clockdiv/KafkaShoes/img/sender.jpg

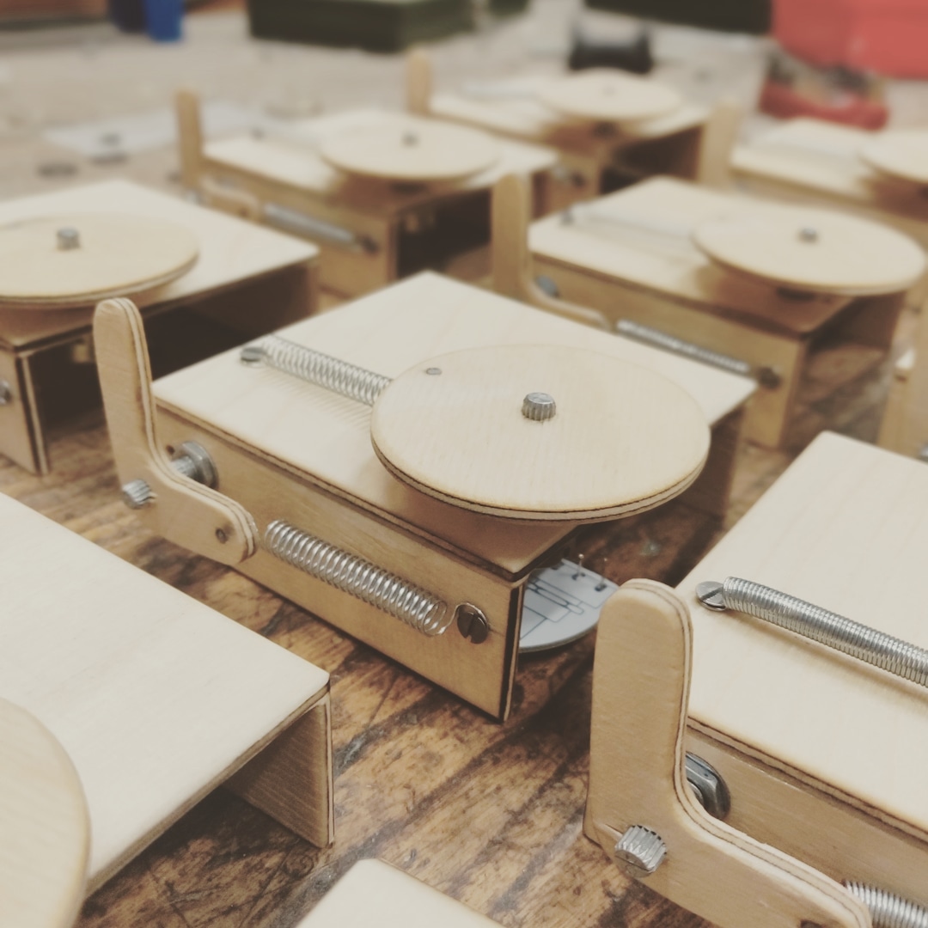
img/sender.jpg
