clockdiv/KafkaShoes/img/shoes_02.jpg

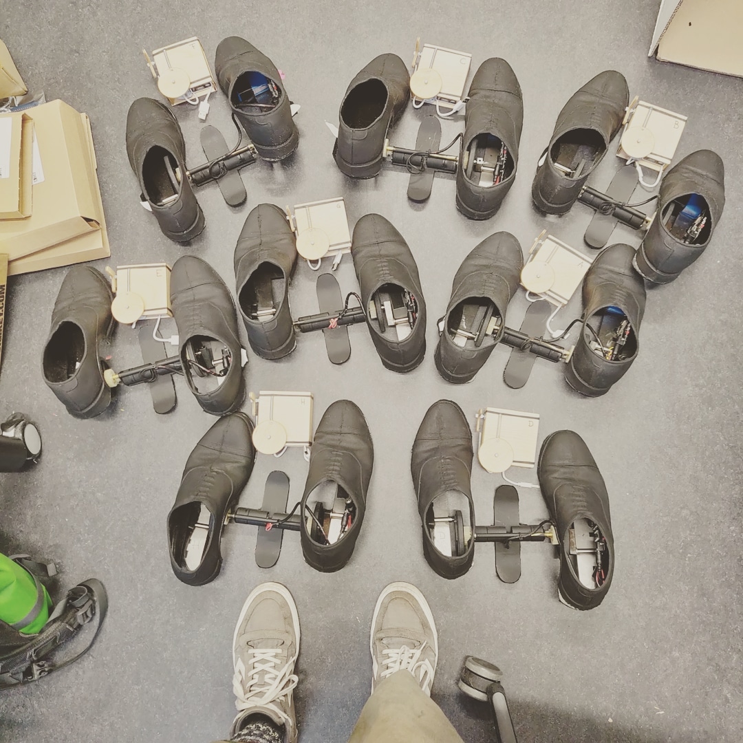
img/shoes_02.jpg
