clockdiv/KafkaShoes/img/shoes_pcb.jpg

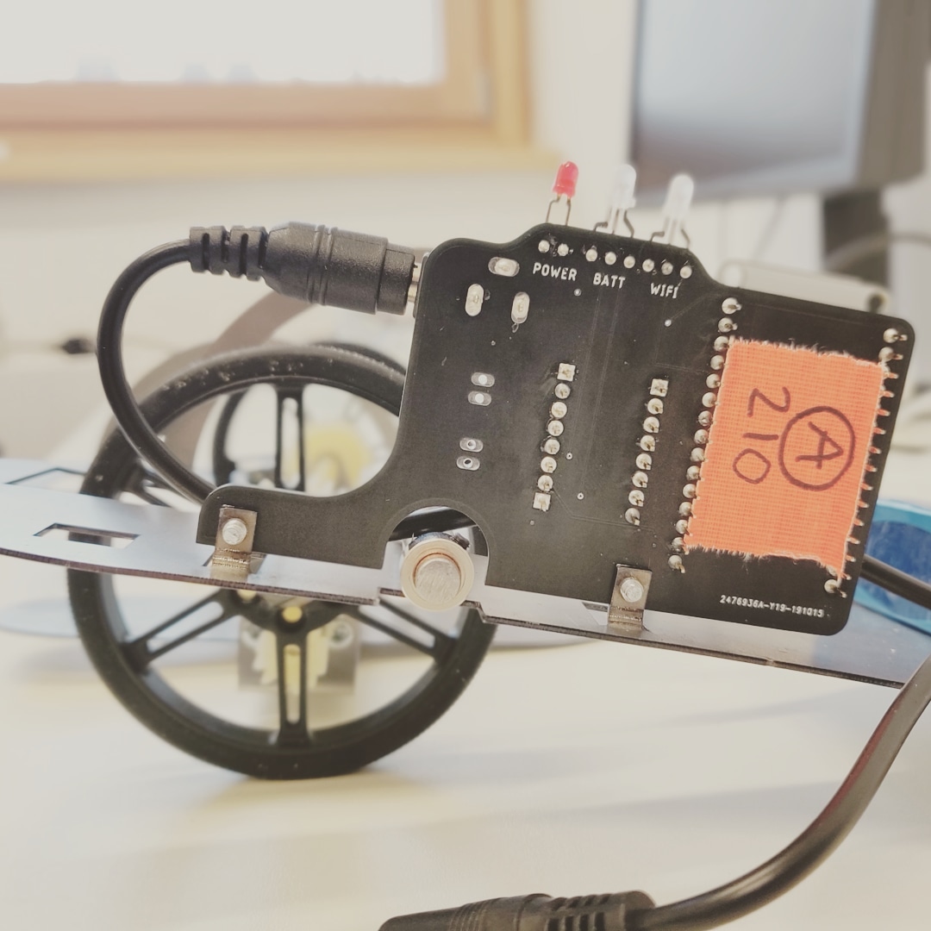
img/shoes_pcb.jpg
