clockdiv/KafkaShoes/HARDWARE/LASER PARTS/Schuhsohle_v02.dxf

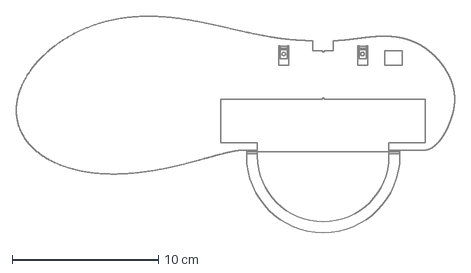
[picture p5: CAD file, 2022-01-22]
HARDWARE/LASER PARTS/Schuhsohle_v02.dxf
30.0 x 14.8 cm
