clockdiv/KafkaShoes/HARDWARE/LASER PARTS/Grundplatte_v02.dxf

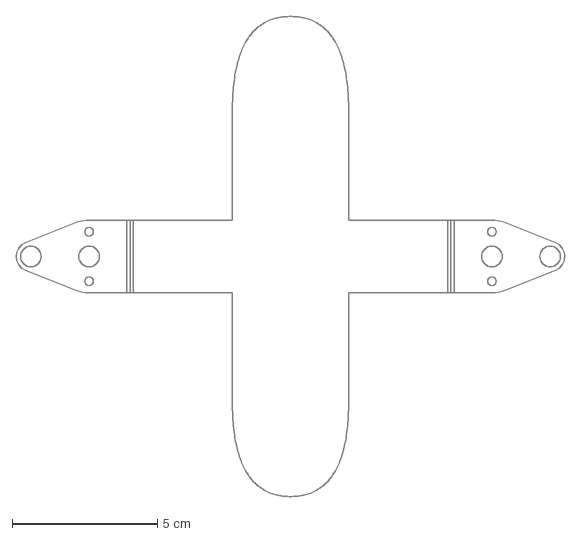
[picture p6: CAD file, 2022-01-22]
HARDWARE/LASER PARTS/Grundplatte_v02.dxf
18.9 x 16.5 cm
