clockdiv/KafkaShoes/HARDWARE/LASER PARTS/Schuhsohle_v01.dxf

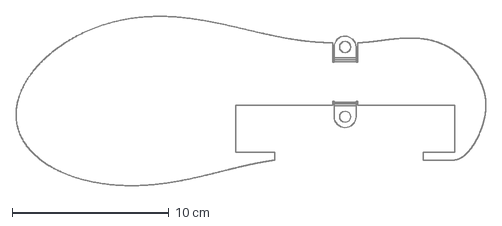
[picture p7: CAD file, 2022-01-22, an earlier design]
HARDWARE/LASER PARTS/Schuhsohle_v01.dxf
30.0 x 10.8 cm
