clockdiv/KafkaShoes/img/shoes_assembly.jpg

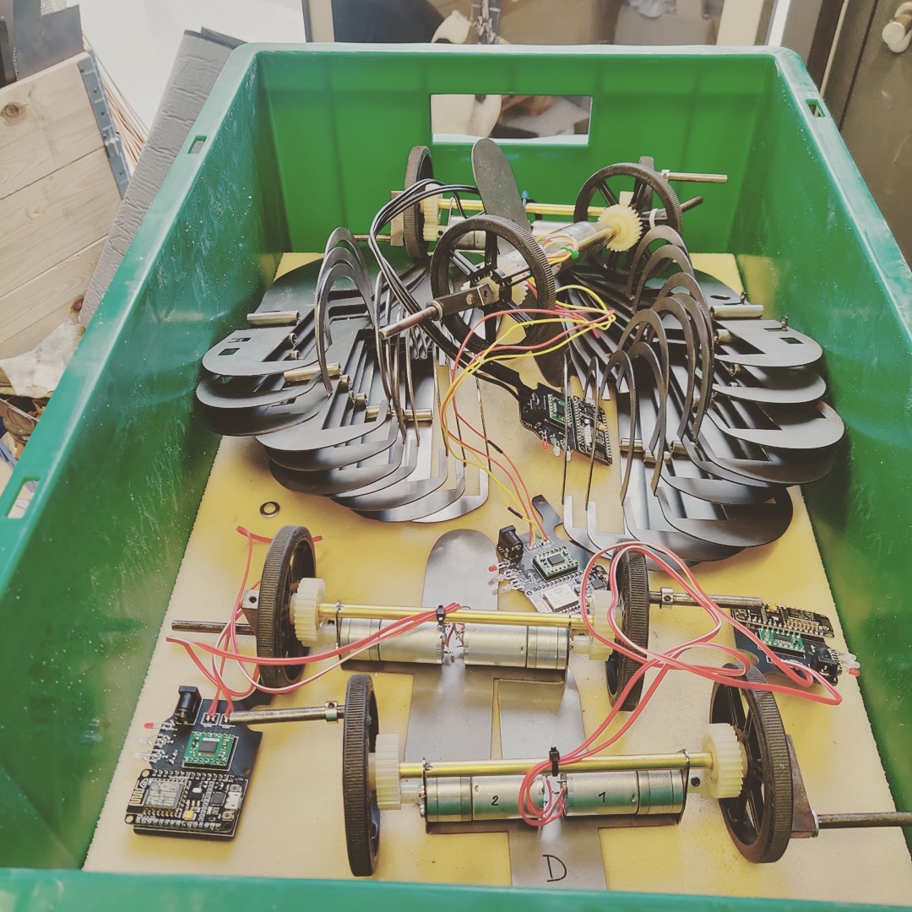
img/shoes_assembly.jpg
