clockdiv/KafkaShoes/HARDWARE/PCB EAGLE/Kafka Schuh V1.3/kafka.pdf

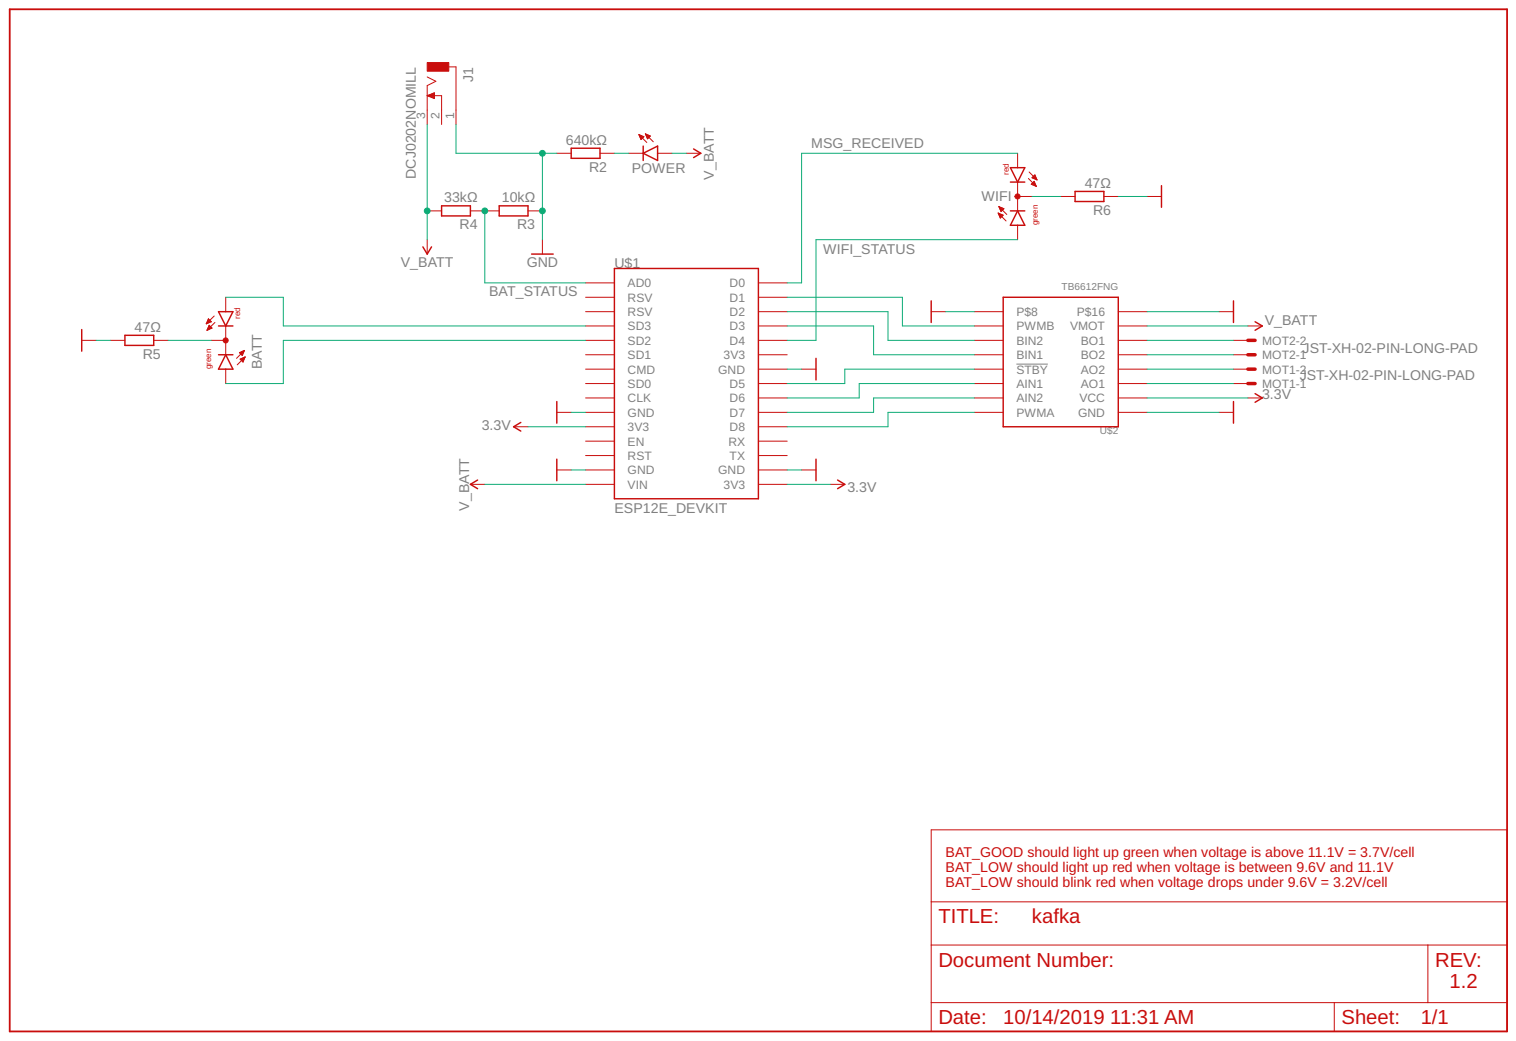
[picture p9: page 1]

JST-XH-02-PIN-LONG-PAD

BAT_GOOD should light up green when voltage is above 11.1V = 3.7V/cell
BAT_LOW should light up red when voltage is between 9.6V and 11.1V
BAT_LOW should blink red when voltage drops under 9.6V = 3.2V/cell
TITLE:

Document Number: | REV: 1.2

Date: 10/14/2019 11:31 AM | Sheet: 1/1

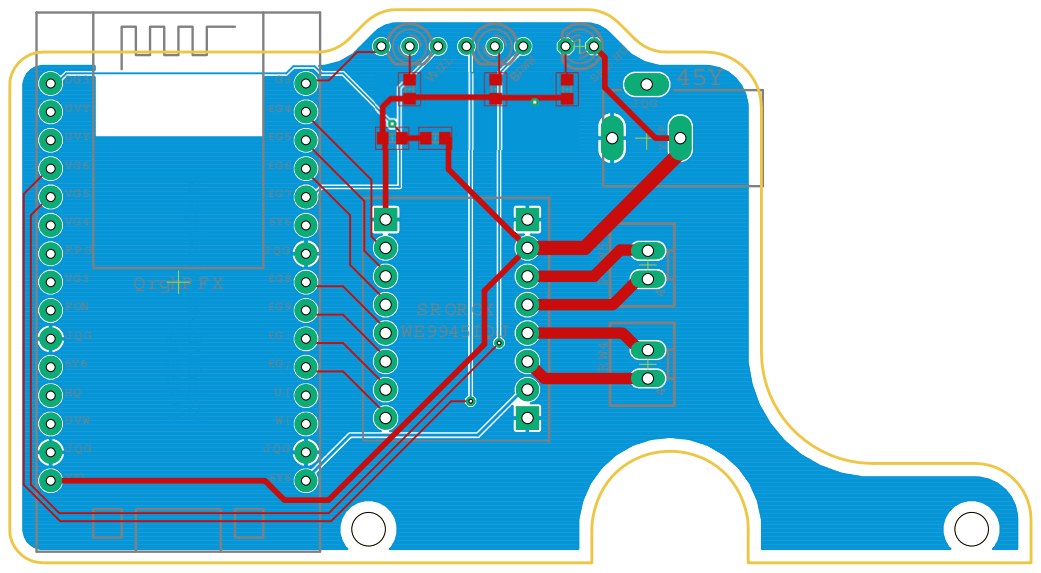
[picture p10: page 2]
VCC; GND; RSV; RST; VIN; IFI; ATT

"Kafka Schuhe" Version 1.3

CMD GND

SD0 N odeM C U | ~D 5
C LK ~D 6 | PO LO LU
GND ~D 7 | TB6612FN G

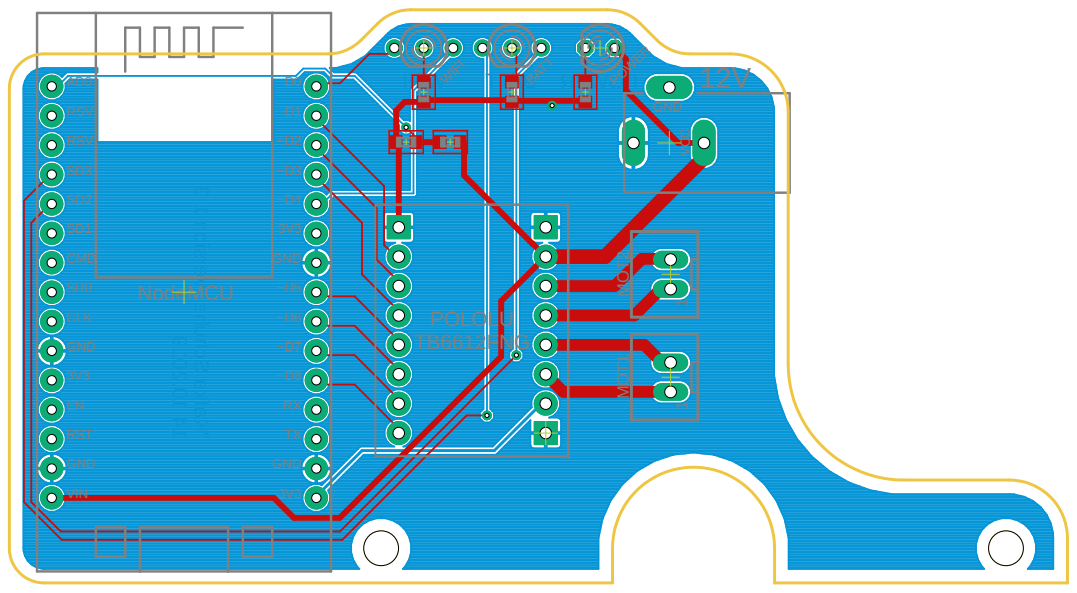
[picture p11: page 3]

"Kafka Schuhe" Version 1.3 14.10.2019 I FI W TTAB RE WOP POLOLU TB6612FNG VCC GND AD0 RSV RSV SD3 SD2 SD1 CMD SD0 CLK GND 3V3 ENRST GND VIN 3V3 GNDTXRX ~D8 ~D7 ~D6 ~D5 GND 3V3 ~D4 ~D3 ~D2 ~D1 D0 1 1 12V NodeMCU WIFI BAT POWER MOT2 MOT1
