clockdiv/KafkaShoes/HARDWARE/LASER PARTS/Kafka_Schuhe_v02.pdf

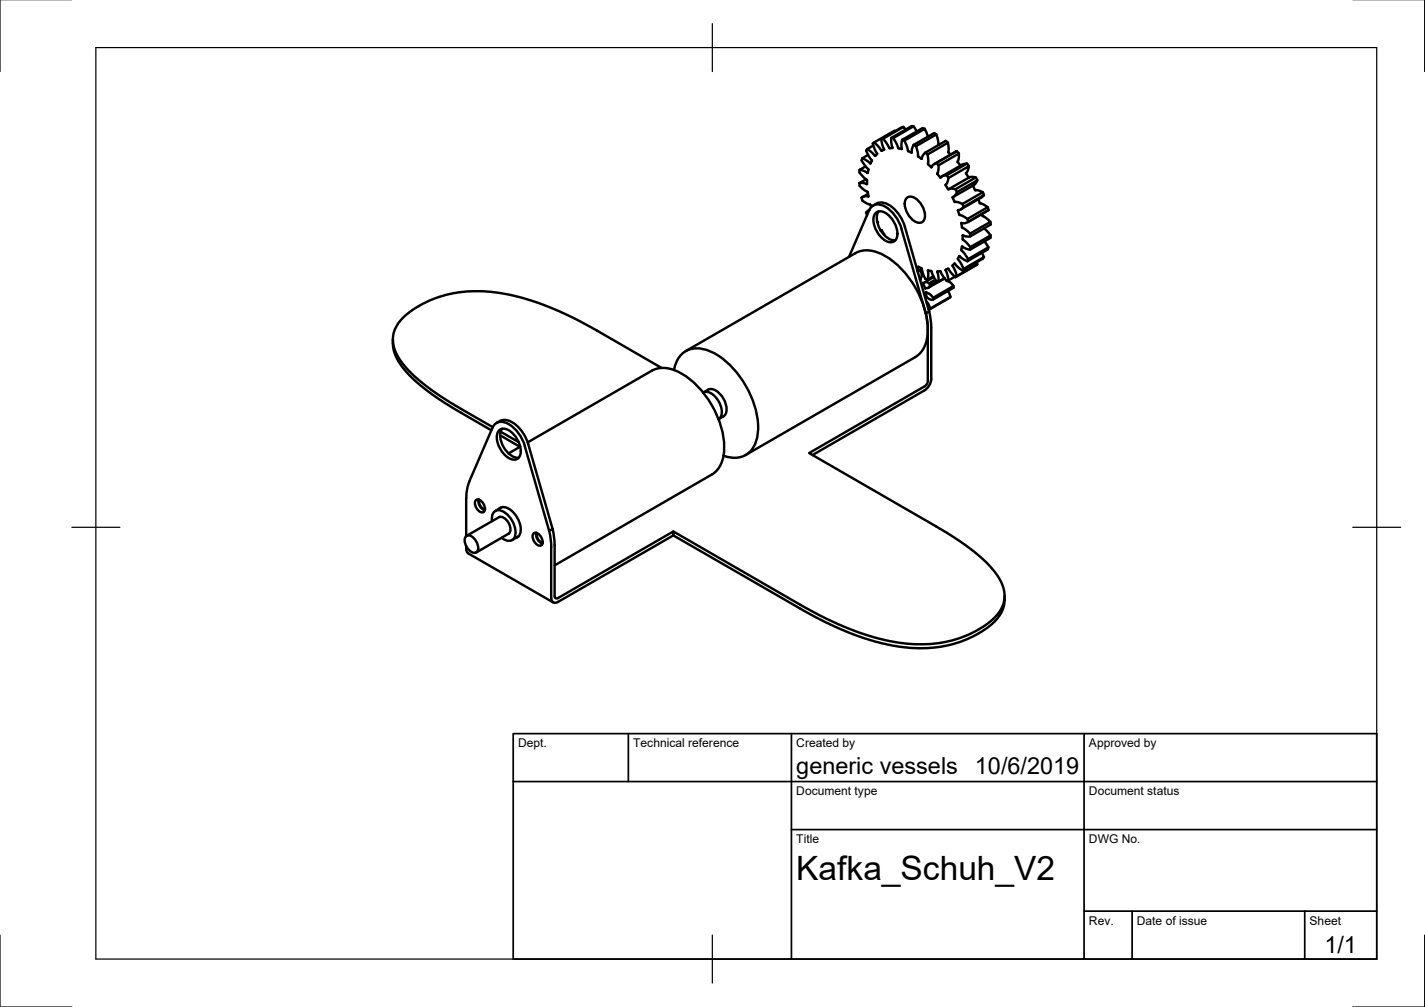
[picture p12: page 1]

Dept. | Technical reference | Created by generic vessels 10/6/2019 | Approved by

Document type | Document status

Title Kafka_Schuh_V2 | DWG No.

Rev. | Date of issue | Sheet

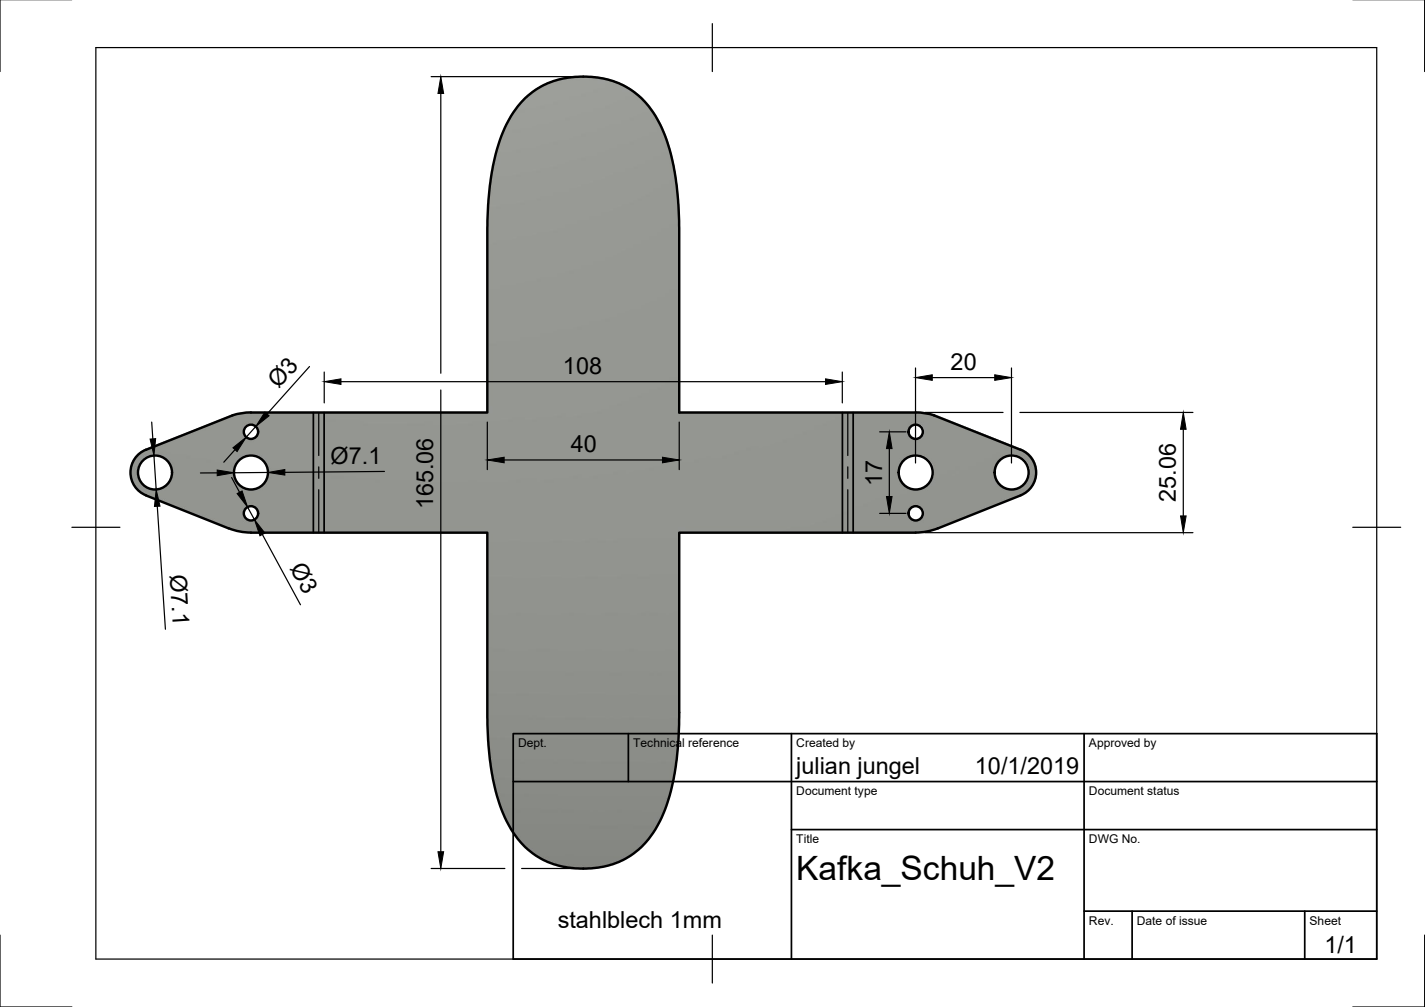
[picture p13: page 2]

Dept. | Technical reference | Created by julian jungel 10/1/2019 | Approved by

stahlblech 1mm | | Document type | Document status

Title Kafka_Schuh_V2 | DWG No.

Rev. | Date of issue | Sheet

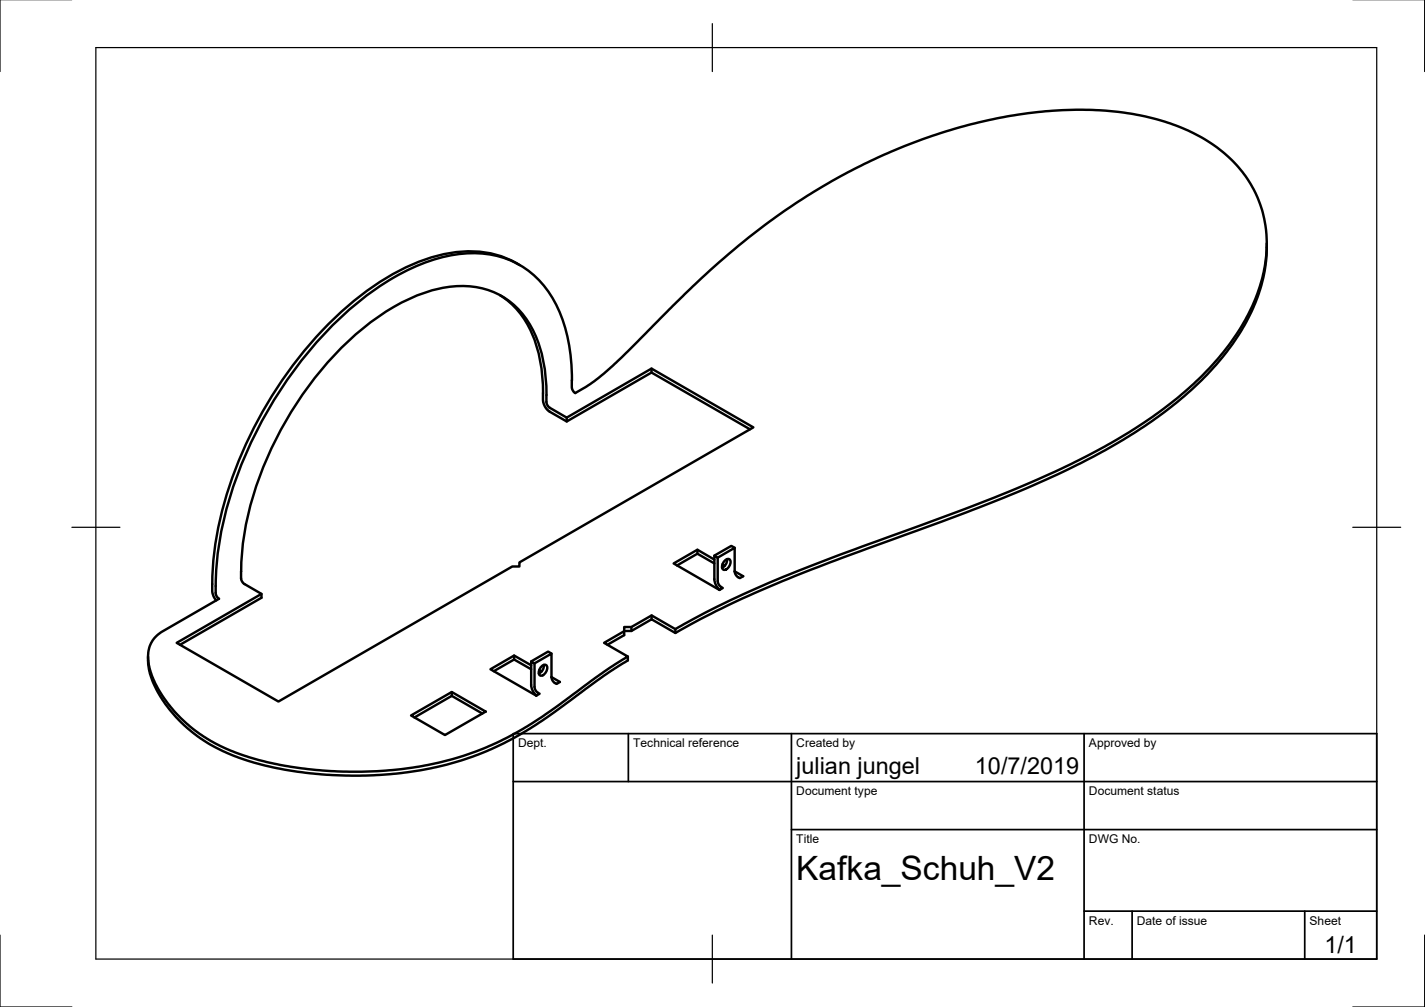
[picture p14: page 3]

Dept. | Technical reference | Created by julian jungel 10/7/2019 | Approved by

Document type | Document status

Title Kafka_Schuh_V2 | DWG No.

Rev. | Date of issue | Sheet

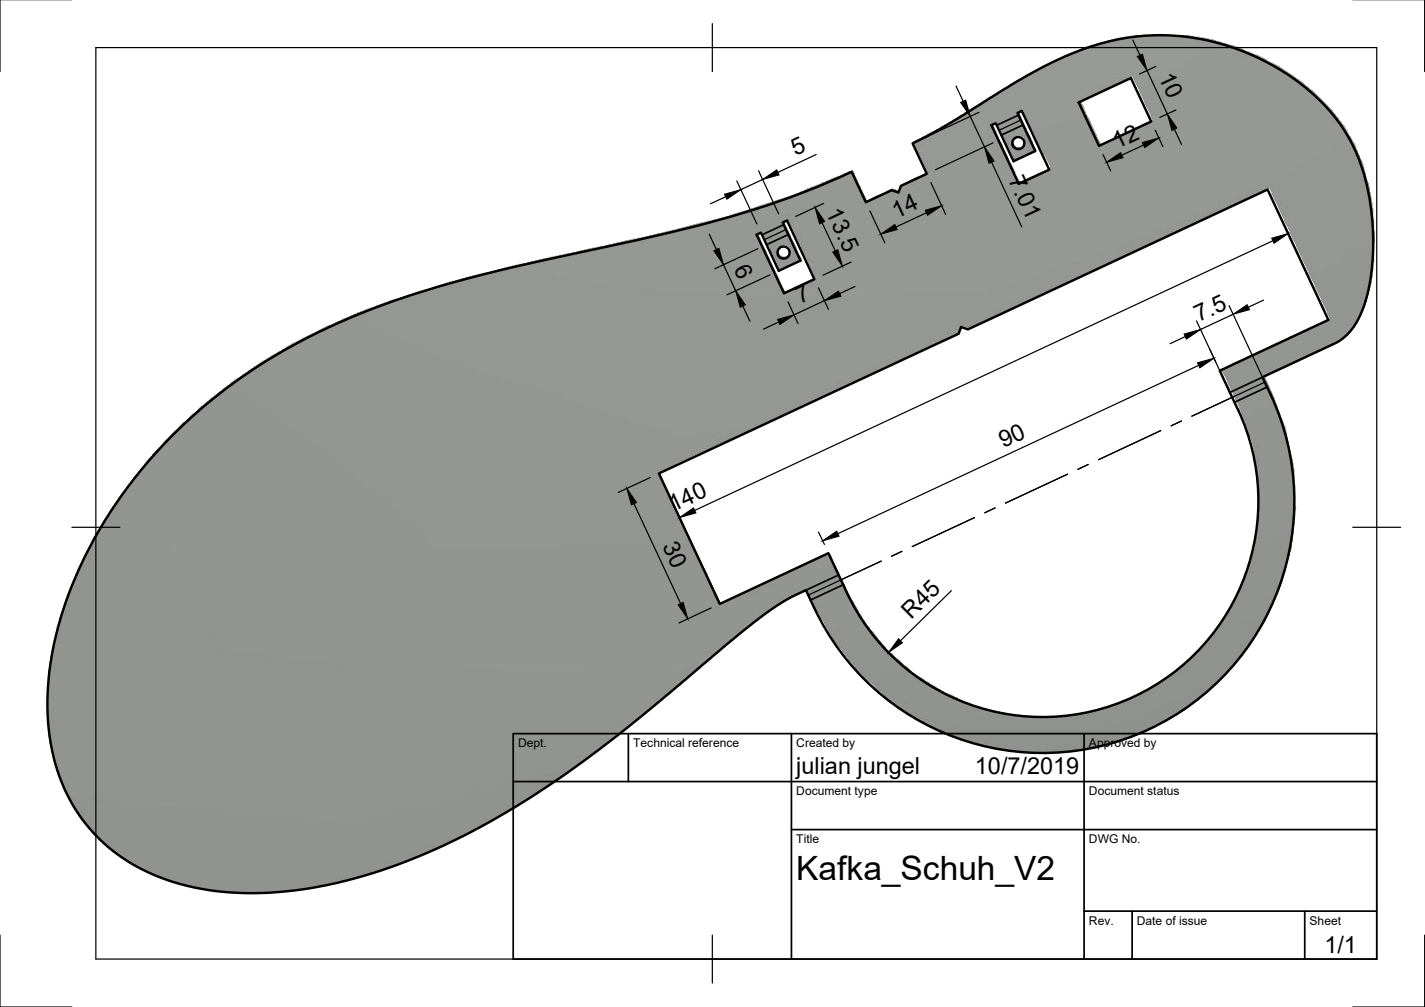
[picture p15: page 4]

Dept. | Technical reference | Created by julian jungel 10/7/2019 | Approved by

Document type | Document status

Title Kafka_Schuh_V2 | DWG No.

Rev. | Date of issue | Sheet
