clockdiv/KafkaShoes/HARDWARE/PCB EAGLE/Kafka Fernsteuerung V1.0/fernsteuerung.brd

## EAGLE design HARDWARE/PCB EAGLE/Kafka Fernsteuerung V1.0/fernsteuerung.brd (2022-01-22)

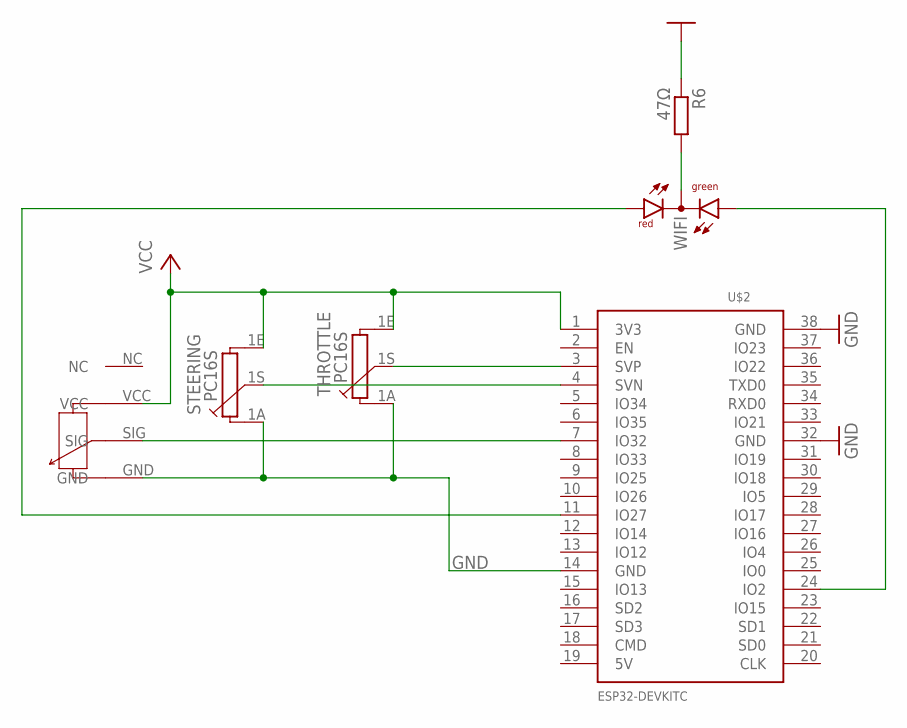
[picture p16: schematic fernsteuerung.sch]

Parts:
R6: 47Ω; R0603
STEERING: PC16S
THROTTLE: PC16S
TRIM: ALPS_RK11K
U$2: ESP32DEVKITC; ESP32-DEVKITC
WIFI: DUOLED-RG-C3MM; DUOLED-A-3MM

Connections:
GND: R6.1, STEERING.1A, THROTTLE.1A, TRIM.GND, U$2.14 (GND), U$2.32 (GND), U$2.38 (GND)
unnamed: U$2.11 (IO27), WIFI.3 (AR)
unnamed: TRIM.SIG, U$2.7 (IO32)
unnamed: STEERING.1S, U$2.4 (SVN)
unnamed: THROTTLE.1S, U$2.3 (SVP)
unnamed: R6.2, WIFI.2 (C)
VCC: STEERING.1E, THROTTLE.1E, TRIM.VCC, U$2.1 (3V3)
WIFI_STATUS: U$2.24 (IO2), WIFI.1 (AG)

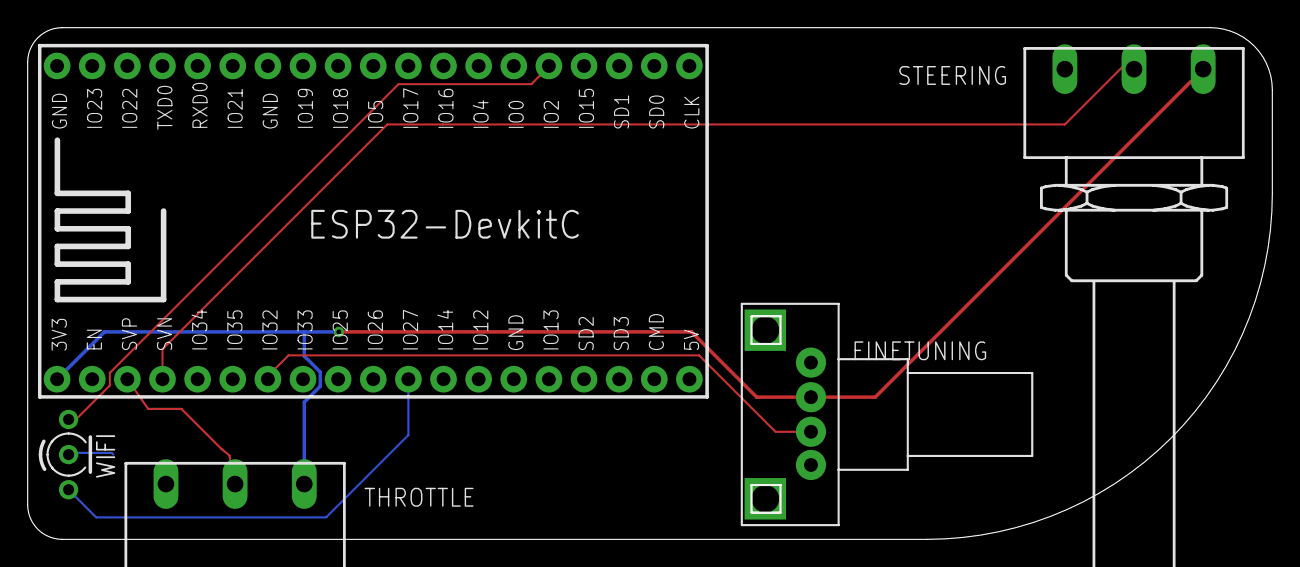
[picture p17: board fernsteuerung.brd from above]

Board: 2 copper layers, 90.0 x 37.0 mm, 6 parts (1 on the bottom side), 8 nets.
