clockdiv/KafkaShoes/HARDWARE/PCB EAGLE/Kafka Schuh V1.3/kafka.brd

## EAGLE design HARDWARE/PCB EAGLE/Kafka Schuh V1.3/kafka.brd (2022-01-22)

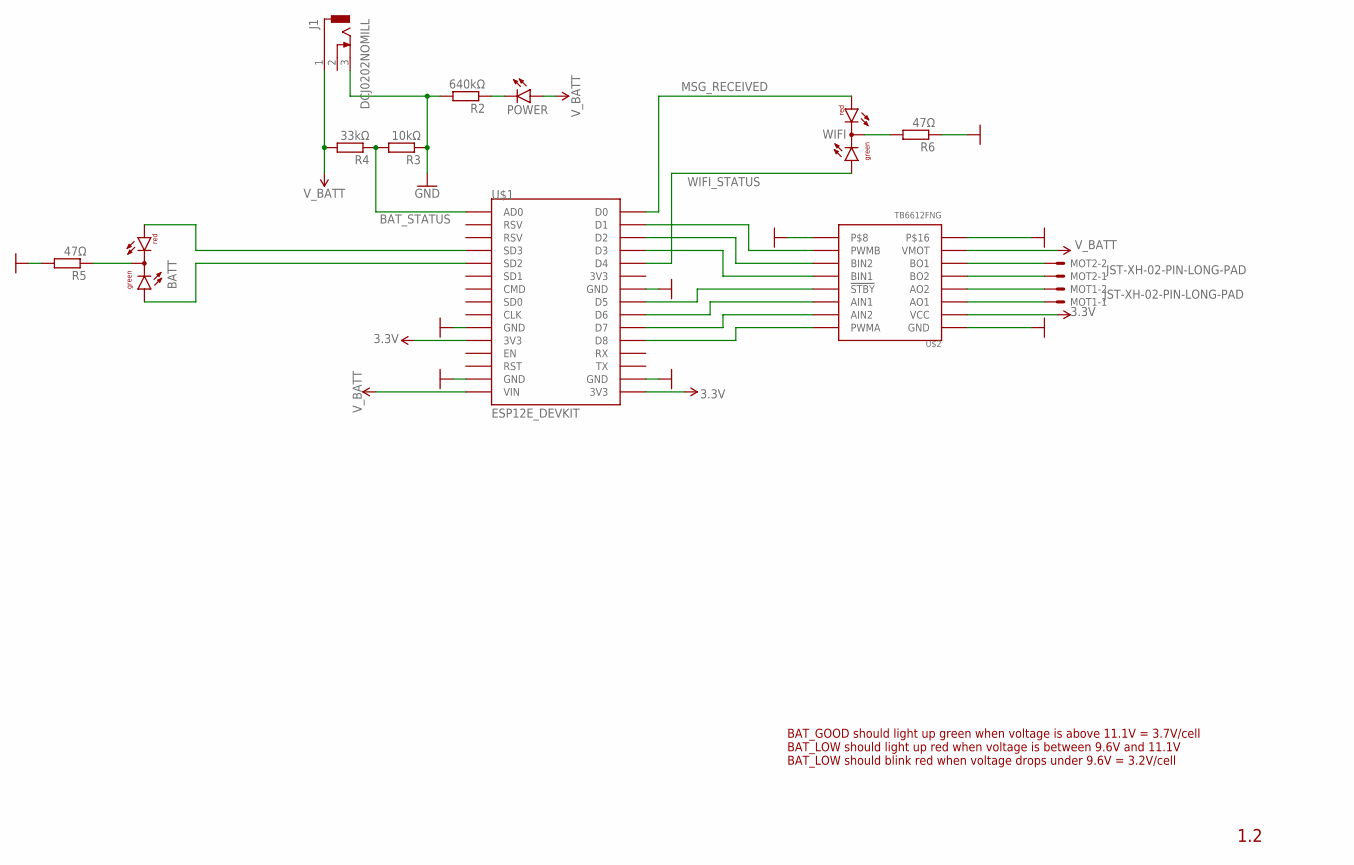
[picture p18: schematic kafka.sch]

Parts:
BATT: DUOLED-RG-C3MM; DUOLED-A-3MM
J1: DCJ0202NOMILL; DCJ0202_NOMILL
MOT1, MOT2: JST-XH-02-PIN-LONG-PAD; JST-XH-02-PACKAGE-LONG-PAD
POWER: LED3MM
R2: 640kΩ; R0603
R3: 10kΩ; R0603
R4: 33kΩ; R0603
R5, R6: 47Ω; R0603
U$1: ESP12E_DEVKIT
U$2: TB6612FNG
WIFI: DUOLED-RG-C3MM; DUOLED-A-3MM

Connections:
3.3V: U$1.3V3@2 (3V3), U$2.VCC
AIN1: U$1.D6, U$2.AIN1
AIN2: U$1.D7, U$2.AIN2
BAT_STATUS: R3.2, R4.1, U$1.AD0
BIN1: U$1.D3, U$2.BIN1
BIN2: U$1.D2, U$2.BIN2
GND: J1.3, R2.2, R3.1, R5.2, R6.1, U$1.GND@0 (GND), U$1.GND@1 (GND), U$1.GND@2 (GND), U$1.GND@3 (GND), U$2.GND, U$2.TB6612FNG1, U$2.TB6612FNG2
MSG_RECEIVED: U$1.D0, WIFI.3 (AR)
unnamed: MOT2.2, U$2.BO1
unnamed: MOT2.1, U$2.BO2
unnamed: MOT1.2, U$2.AO2
unnamed: MOT1.1, U$2.AO1
unnamed: R6.2, WIFI.2 (C)
unnamed: POWER.K (C), R2.1
unnamed: BATT.1 (AG), U$1.SD2
unnamed: BATT.3 (AR), U$1.SD3
unnamed: BATT.2 (C), R5.1
PWMA: U$1.D8, U$2.PWMA
PWMB: U$1.D1, U$2.PWMB
STBY: U$1.D5, U$2.!STBY
V_BATT: J1.1, POWER.A, R4.2, U$1.VIN, U$2.VMOT
WIFI_STATUS: U$1.D4, WIFI.1 (AG)

Notes on the sheet:
1.2
BAT_GOOD should light up green when voltage is above 11.1V = 3.7V/cell BAT_LOW should light up red when voltage is between 9.6V and 11.1V BAT_LOW should blink red when voltage drops under 9.6V = 3.2V/cell

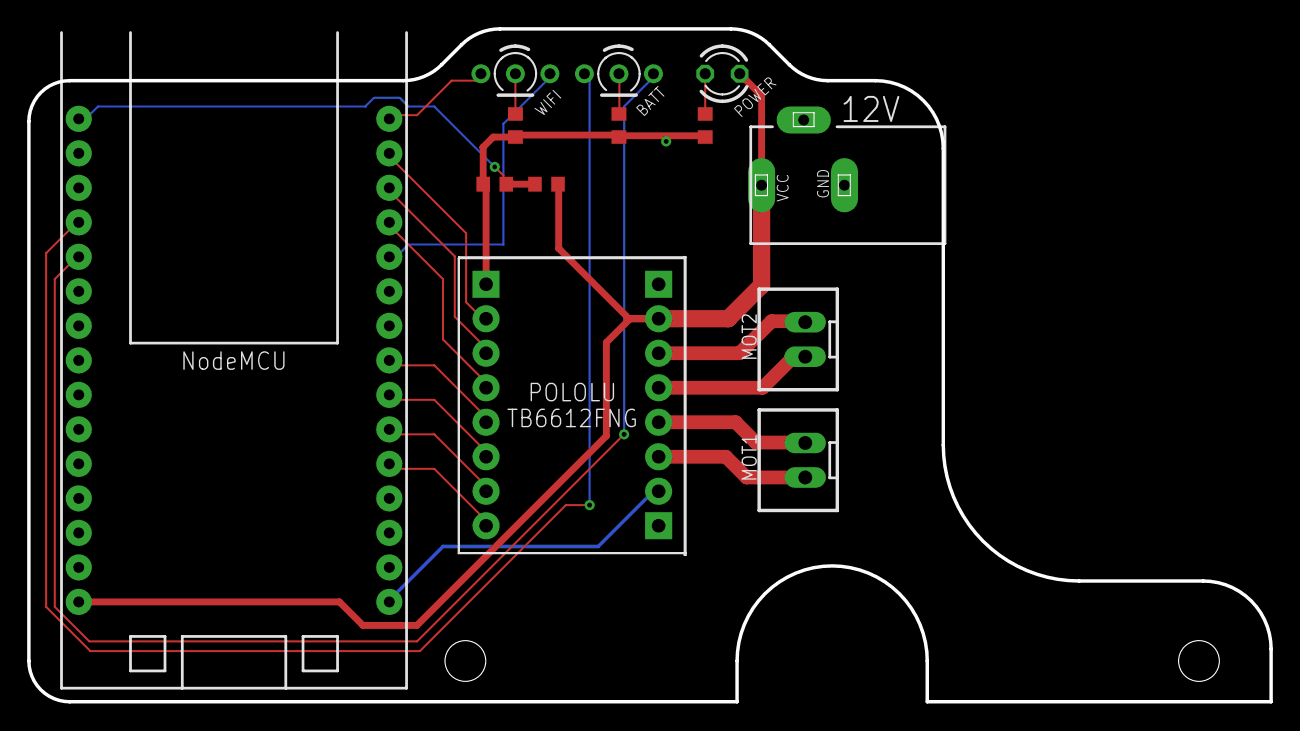
[picture p19: board kafka.brd from above]

Board: 2 copper layers, 91.4 x 49.5 mm, 13 parts (0 on the bottom side), 22 nets.
